EGusb/Localizador-GPS-via-SMS/Imágenes/pinout_Neo_6m.jpg

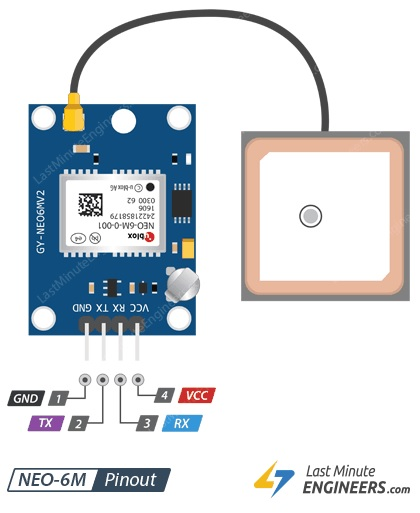
Imágenes/pinout_Neo_6m.jpg
