EGusb/Localizador-GPS-via-SMS/Imágenes/prototipo_02.jpg

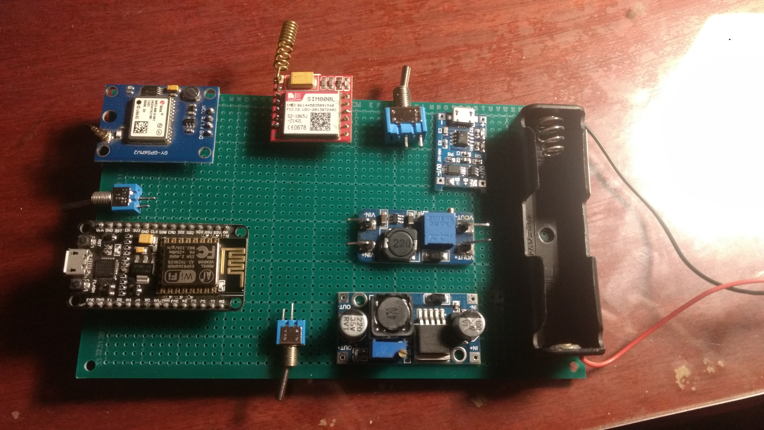
Imágenes/prototipo_02.jpg
