EGusb/Localizador-GPS-via-SMS/Esquemas/conexion_01_energia.jpg

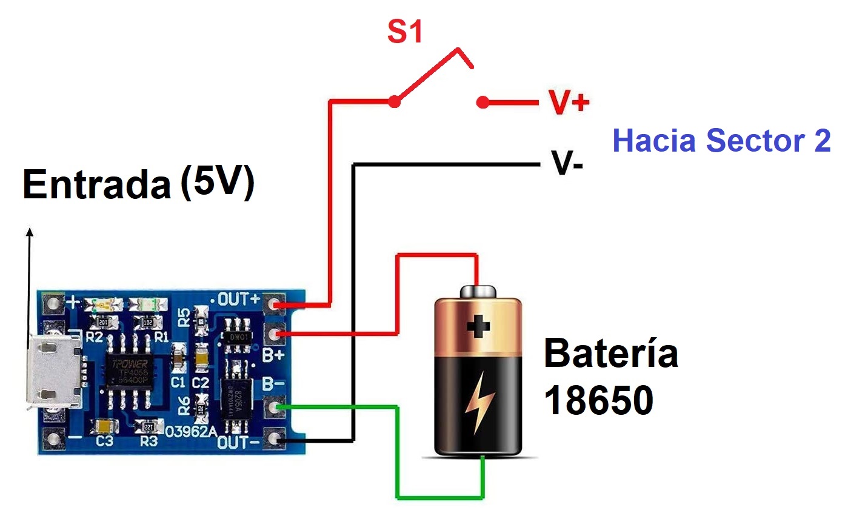
Esquemas/conexion_01_energia.jpg
