EGusb/Localizador-GPS-via-SMS/Esquemas/conexion_02_regulacion_voltaje.jpg

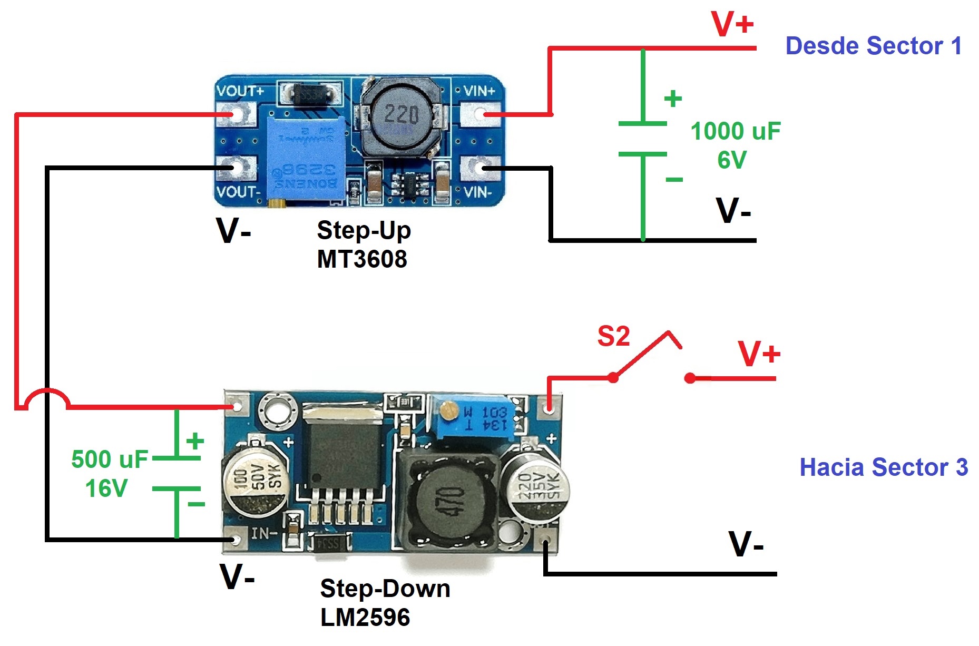
Esquemas/conexion_02_regulacion_voltaje.jpg
