EGusb/Localizador-GPS-via-SMS/Esquemas/conexion_03_datos.jpg

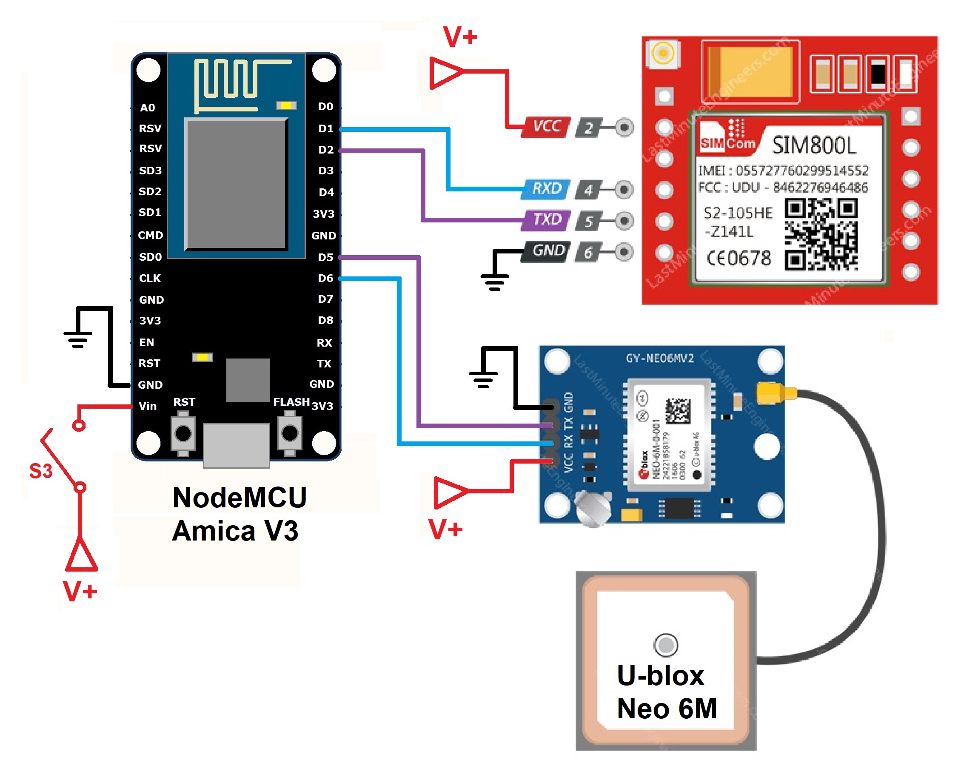
Esquemas/conexion_03_datos.jpg
