EGusb/Localizador-GPS-via-SMS/Esquemas/diag_flujo_01_global.png

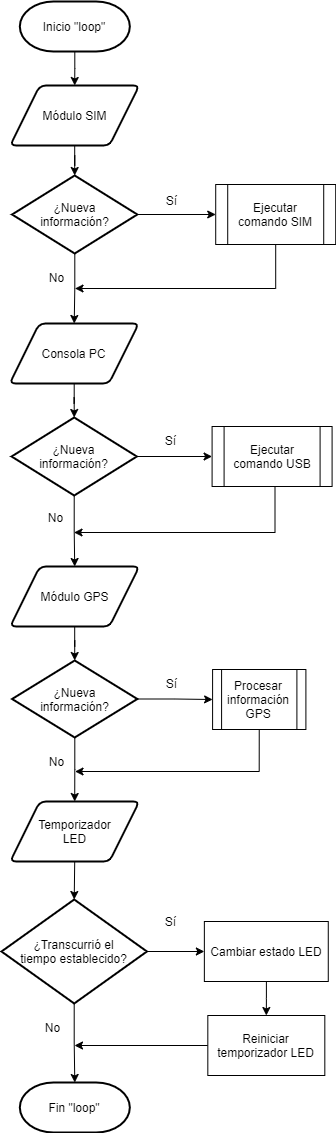
Esquemas/diag_flujo_01_global.png
