EGusb/Localizador-GPS-via-SMS/Esquemas/diag_flujo_02_comando_SIM.png

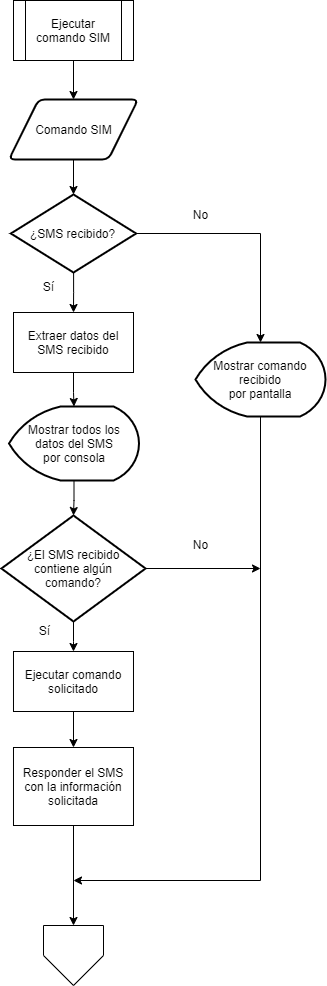
Esquemas/diag_flujo_02_comando_SIM.png
