EGusb/Localizador-GPS-via-SMS/Esquemas/diag_flujo_03_comando_USB.png

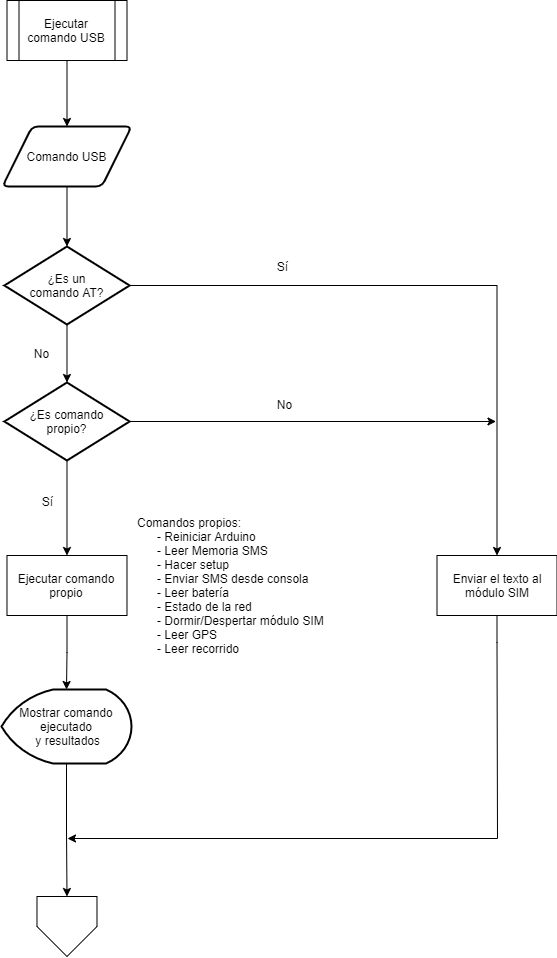
Esquemas/diag_flujo_03_comando_USB.png
