EGusb/Localizador-GPS-via-SMS/Esquemas/diag_flujo_03_comando_USB_reducido.png

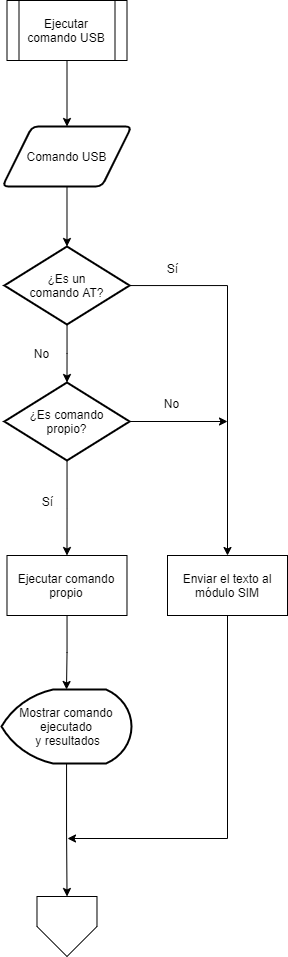
Esquemas/diag_flujo_03_comando_USB_reducido.png
