EGusb/Localizador-GPS-via-SMS/Esquemas/diag_flujo_04_info_GPS.png

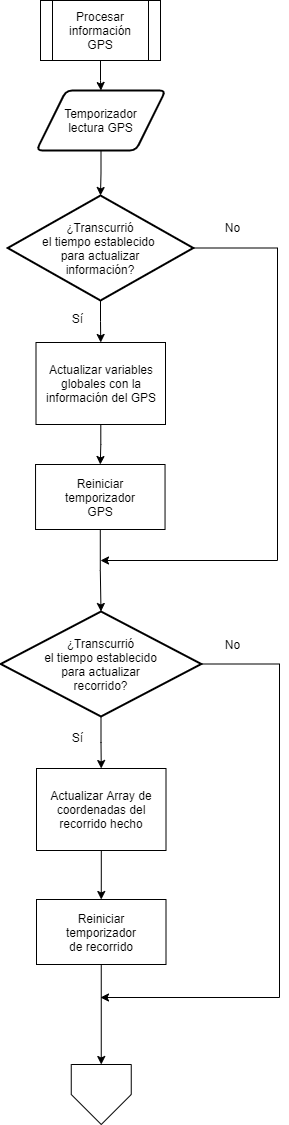
Esquemas/diag_flujo_04_info_GPS.png
