EGusb/Localizador-GPS-via-SMS/Imágenes/ascii_table.jpg

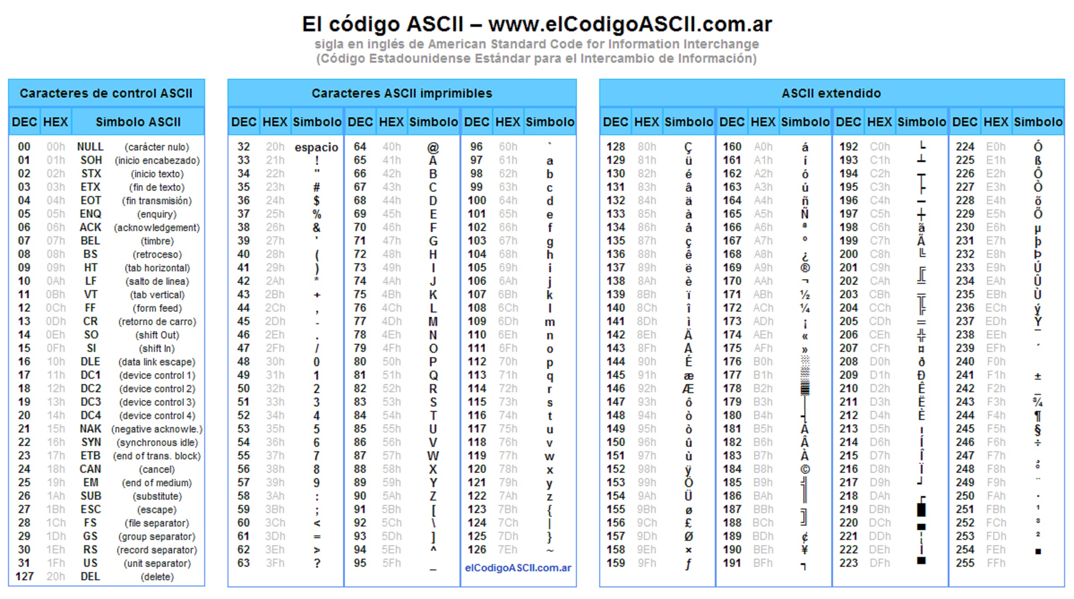
Imágenes/ascii_table.jpg
