EGusb/Localizador-GPS-via-SMS/Imágenes/prototipo_01.jpg

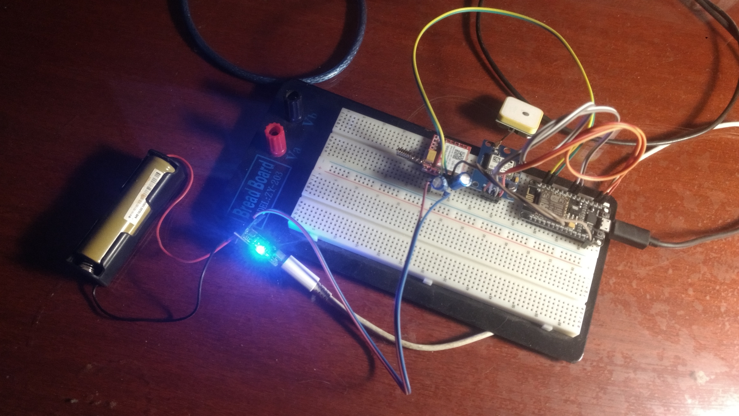
Imágenes/prototipo_01.jpg
