EGusb/Localizador-GPS-via-SMS/Imágenes/prototipo_03.jpg

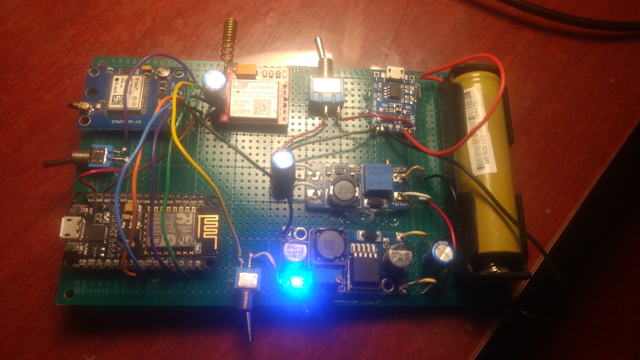
Imágenes/prototipo_03.jpg
