EGusb/Localizador-GPS-via-SMS/Imágenes/prototipo_09_sectores.jpg

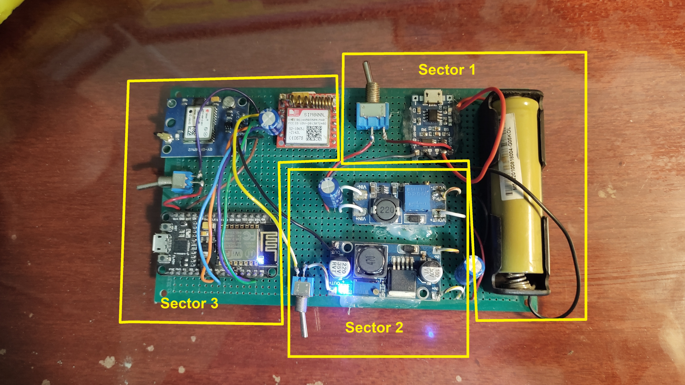
Imágenes/prototipo_09_sectores.jpg
