EGusb/Localizador-GPS-via-SMS/Imágenes/sector_full.jpg

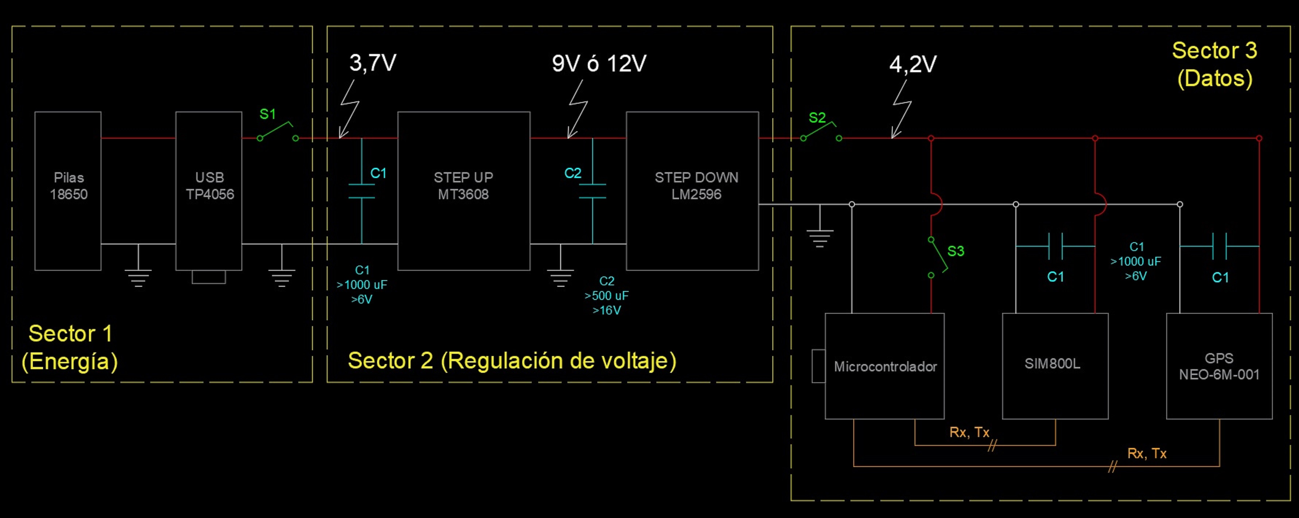
Imágenes/sector_full.jpg
