EGusb/Localizador-GPS-via-SMS/Screenshots/Screenshot_01.png

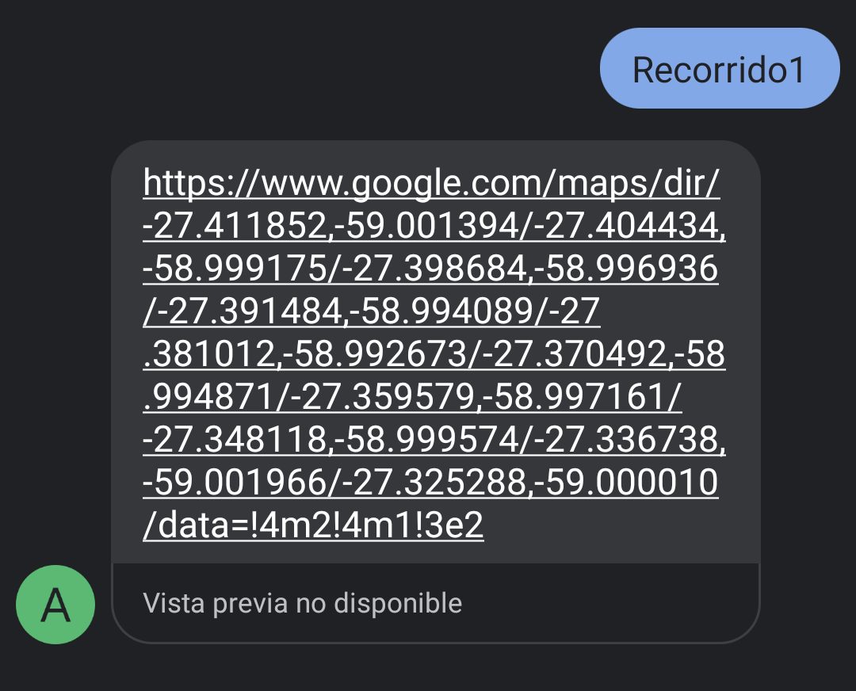
Screenshots/Screenshot_01.png
