EGusb/Localizador-GPS-via-SMS/Screenshots/Screenshot_02.png

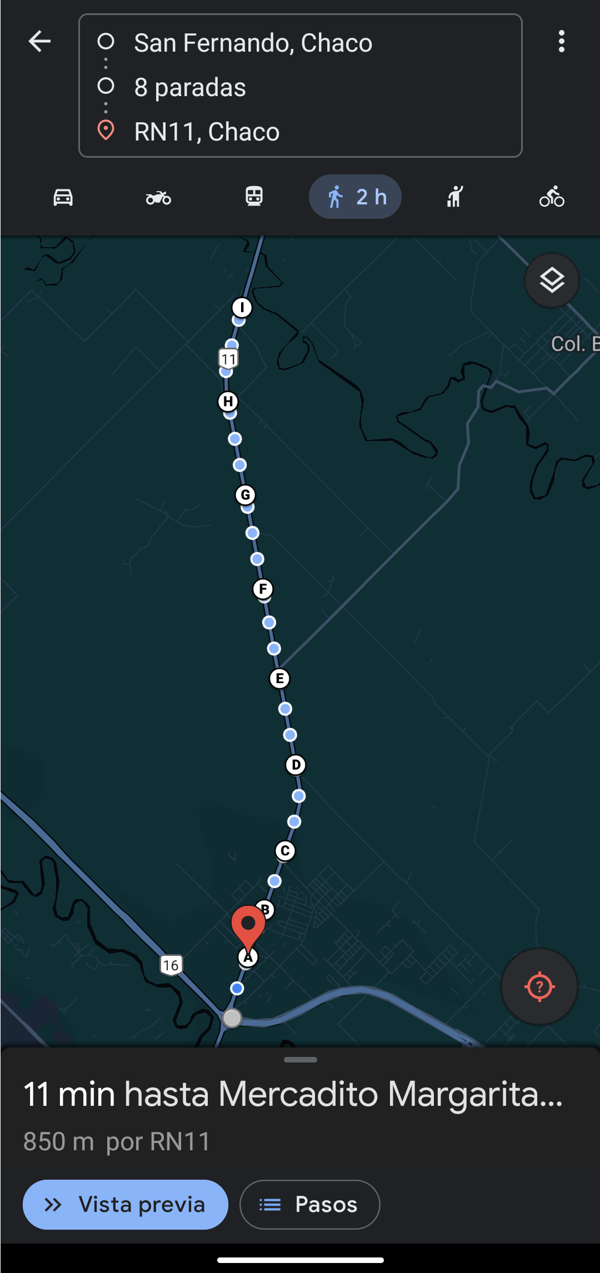
Screenshots/Screenshot_02.png
