EGusb/Localizador-GPS-via-SMS/Screenshots/Screenshot_03.png

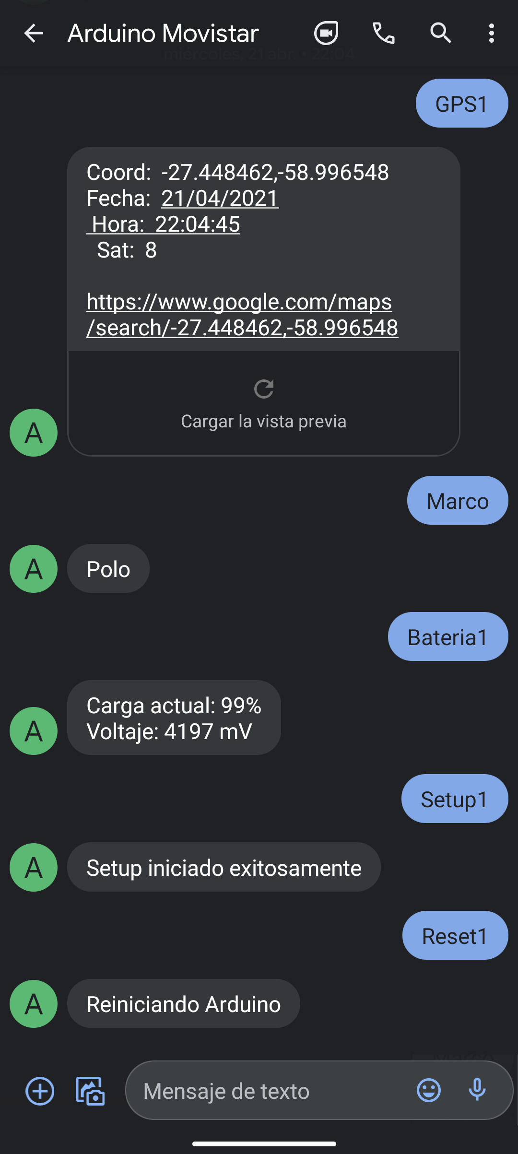
Screenshots/Screenshot_03.png
