EGusb/Localizador-GPS-via-SMS/Screenshots/Screenshot_04.png

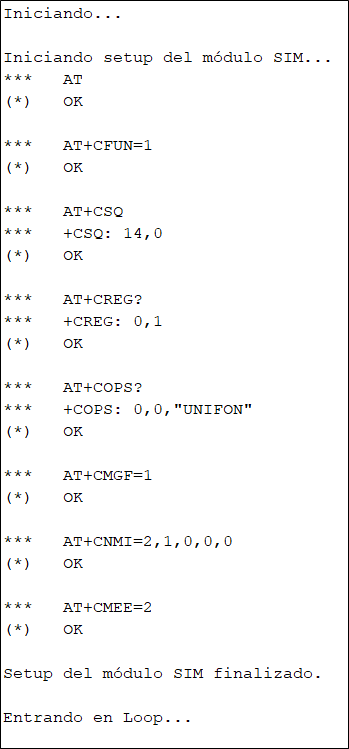
Screenshots/Screenshot_04.png
