EGusb/Localizador-GPS-via-SMS/Screenshots/Screenshot_05.png

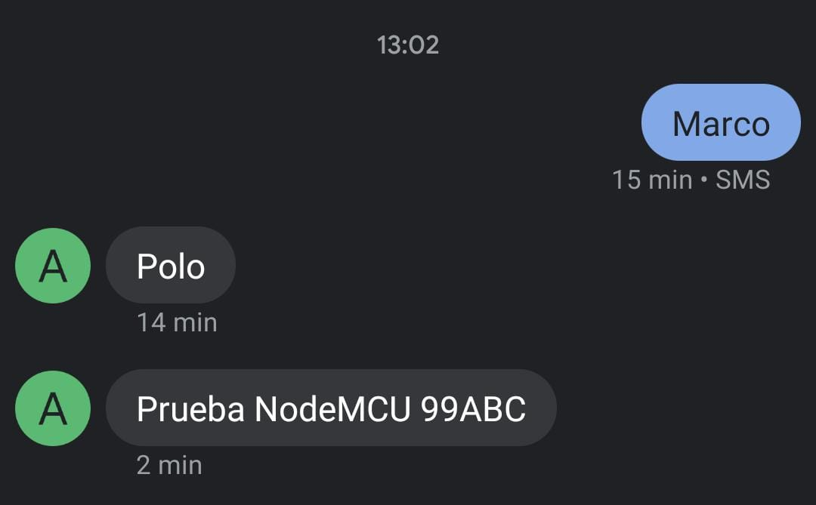
Screenshots/Screenshot_05.png
