EGusb/Localizador-GPS-via-SMS/Screenshots/Screenshot_06.png

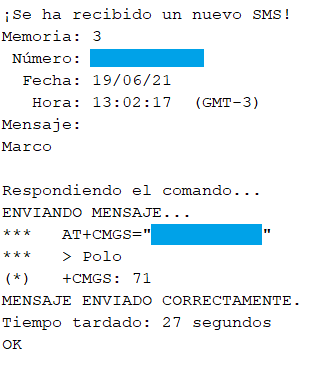
Screenshots/Screenshot_06.png
