EGusb/Localizador-GPS-via-SMS/Screenshots/Screenshot_07.png

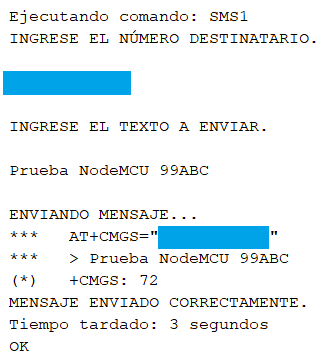
Screenshots/Screenshot_07.png
