EGusb/Localizador-GPS-via-SMS/(list of files, cad)

Other CAD files:
Esquemas/esquema_sectores.dwg
