EGusb/Localizador-GPS-via-SMS/(commit log)

2021-04-25 limpio la función extraer_info_sms
2021-05-03 arreglo comentarios y variable TIMEZONE
    [localizador_GPS_SMS.ino]
2021-05-24 agrego bibliografia y esquema, cambio carpeta codigo
    [esquema_sectores.dwg]
2021-05-24 modificaciones menores
    [esquema_sectores.dwg]
2021-05-24 edito informe
    [esquema_sectores.dwg]
2021-05-24 modifico informe, esquema y agrego datasheet SIM800L
    [esquema_sectores.dwg]
2021-06-09 Muevo esquema_sectores.dwg
    [esquema_sectores.dwg]
2021-06-09 modifico diagramas de flujo
2021-06-16 actualizo diagramas de flujo, y otros
2021-06-16 agrego esquemas de conexion
2021-06-19 agrego diag de flujo al informe
2021-07-25 agrego imágenes de sectores
